CalSol/calsol-hw-libs/README.md

# calsol-hw-libs
CalSol's shared libraries for hardware -- KiCAD libraries and footprints.

## Repository Structure
This is meant to be [submoduled](https://git-scm.com/book/en/v2/Git-Tools-Submodules) into a higher-level project.

- [layout.pretty] - Footprints go here.
- [schematic] - Schematic elements go here.
- [schematic_kicad] - This is a dump of the current KiCAD library set. Don't change these unless you have a compelling reason to (ie. the KiCAD libraries have been updated)
