CalSol/calsol-hw-libs/3D_footprints/HX1188NLT/HX1188NLT.stp

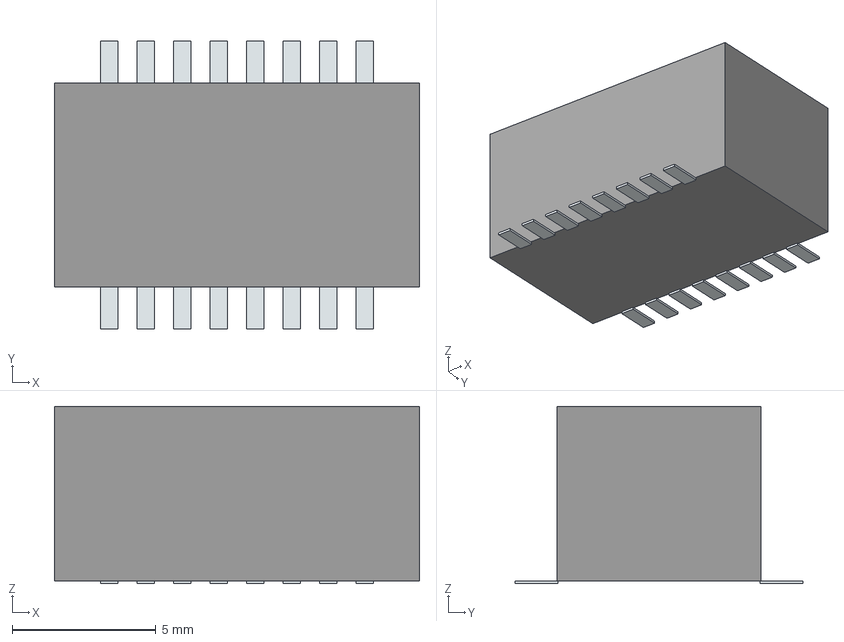
[picture p1: CAD file, 2019-12-28]
3D_footprints/HX1188NLT/HX1188NLT.stp
12.7 x 10.0 x 6.17 mm
('pin',_'1')
('pin',_'2')
('pin',_'3')
('pin',_'4')
('pin',_'5')
('pin',_'6')
('pin',_'7')
('pin',_'8')
('pin',_'9')
('pin',_'10')
('pin',_'11')
('pin',_'12')
('pin',_'13')
('pin',_'14')
('pin',_'15')
('pin',_'16')
