CalSol/calsol-hw-libs/3D_footprints/LTC2309HF#PBF/LTC2309HF#PBF.stp

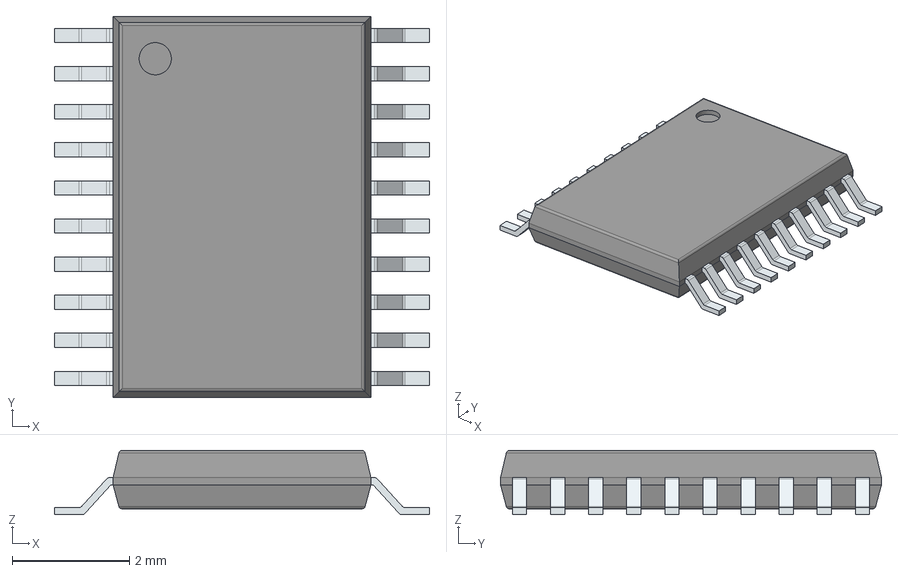
[picture p2: CAD file, 2019-12-28]
3D_footprints/LTC2309HF#PBF/LTC2309HF#PBF.stp
6.40 x 6.50 x 1.10 mm
PinsArrayLR
