CalSol/calsol-hw-libs/3D_footprints/LTC6811-1/LTC6811-1.stp

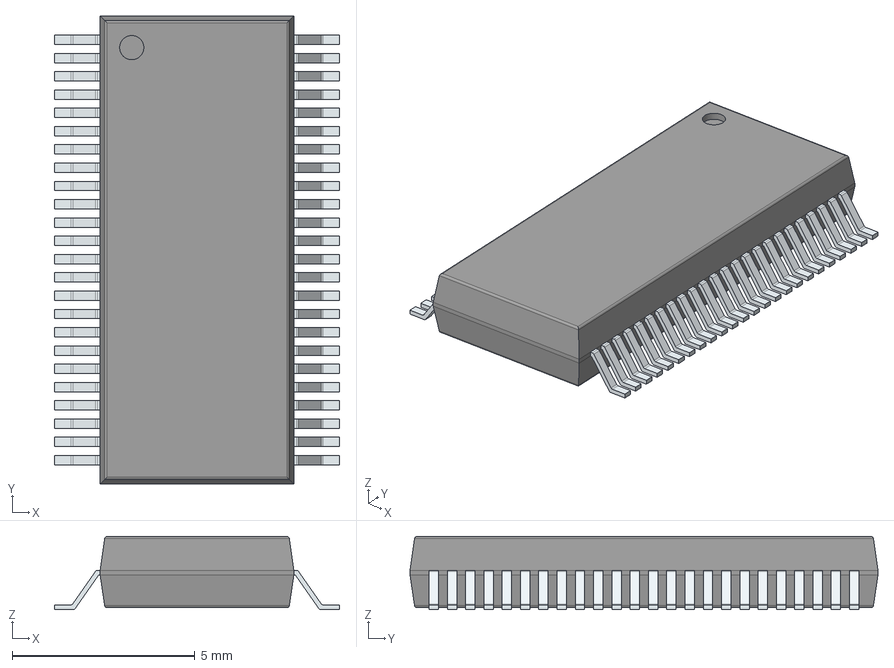
[picture p3: CAD file, 2019-12-28]
3D_footprints/LTC6811-1/LTC6811-1.stp
7.80 x 12.8 x 2.00 mm
PinsArrayLR
