CalSol/calsol-hw-libs/3D_footprints/MOLEX_5023520400/5023520400.stp

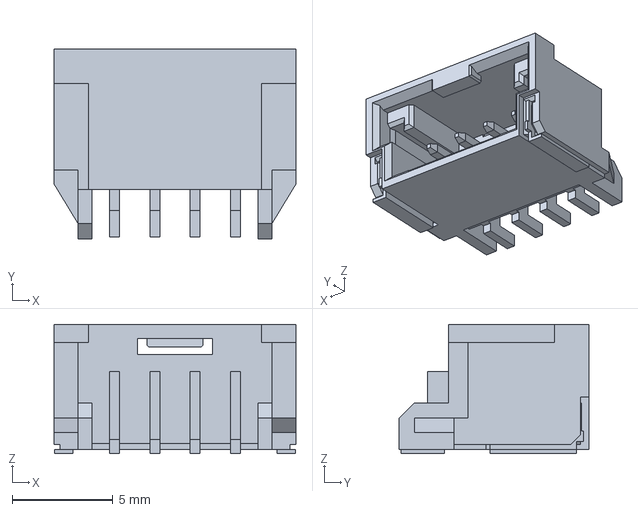
[picture p4: CAD file, 2019-12-28]
3D_footprints/MOLEX_5023520400/5023520400.stp
12.0 x 9.40 x 6.40 mm
