CalSol/calsol-hw-libs/3D_footprints/MOLEX_5023520500/5023520500.stp

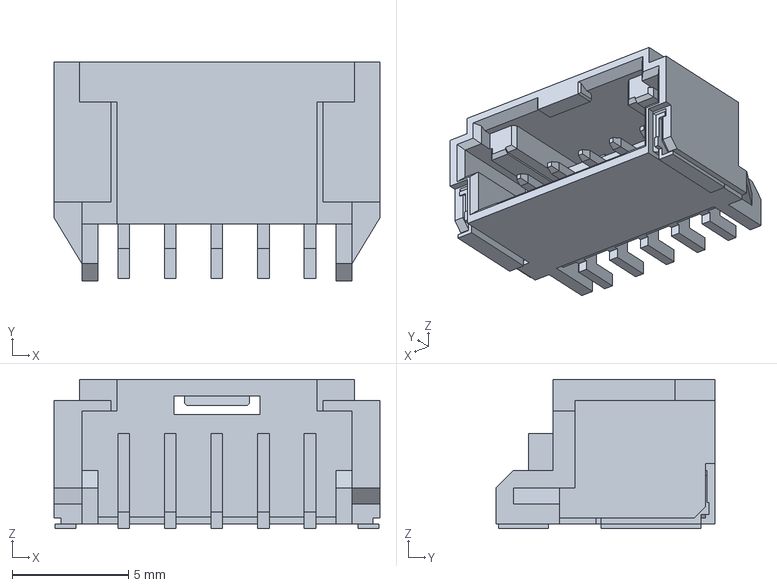
[picture p5: CAD file, 2019-12-28]
3D_footprints/MOLEX_5023520500/5023520500.stp
14.0 x 9.40 x 6.40 mm
