CalSol/calsol-hw-libs/3D_footprints/MOLEX_5600200220/5600200220.stp

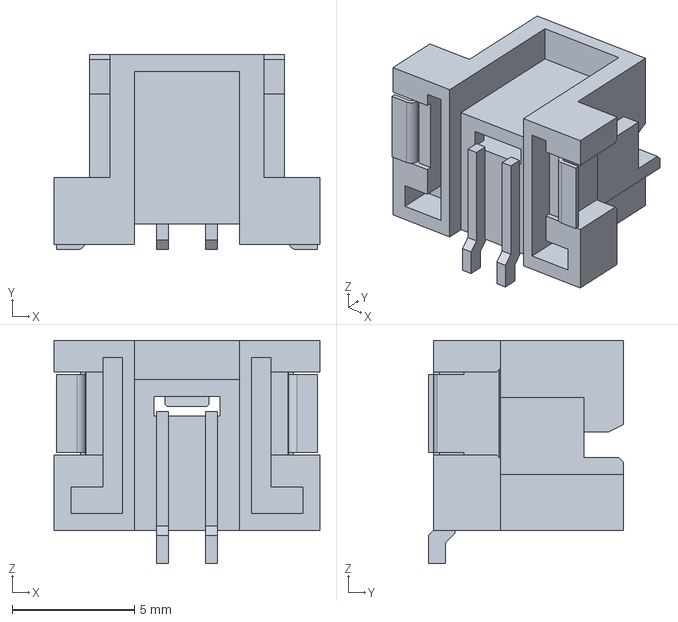
[picture p6: CAD file, 2019-12-28]
3D_footprints/MOLEX_5600200220/5600200220.stp
10.9 x 8.00 x 9.15 mm
