CalSol/calsol-hw-libs/3D_footprints/MOLEX_5600200320/5600200320.stp

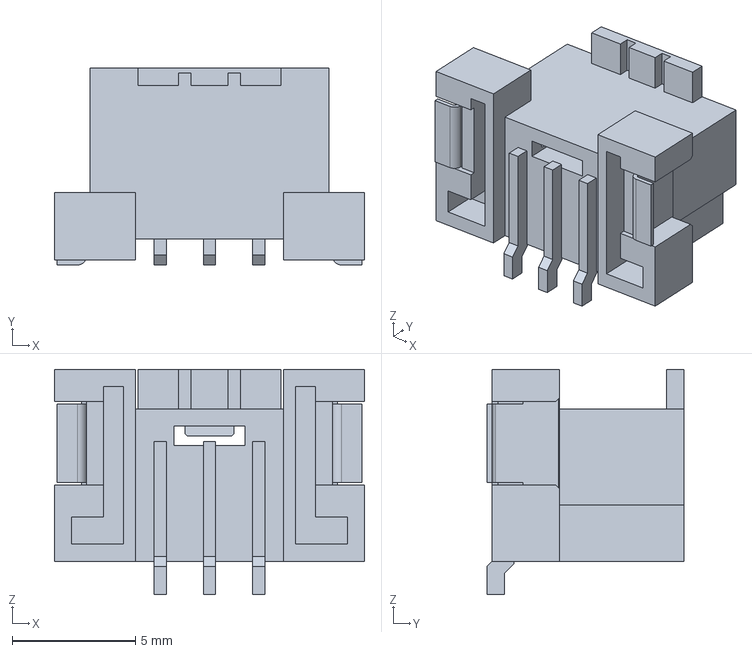
[picture p7: CAD file, 2019-12-28]
3D_footprints/MOLEX_5600200320/5600200320.stp
12.6 x 8.00 x 9.15 mm
