CalSol/calsol-hw-libs/3D_footprints/MOLEX_5600200420/5600200420.stp

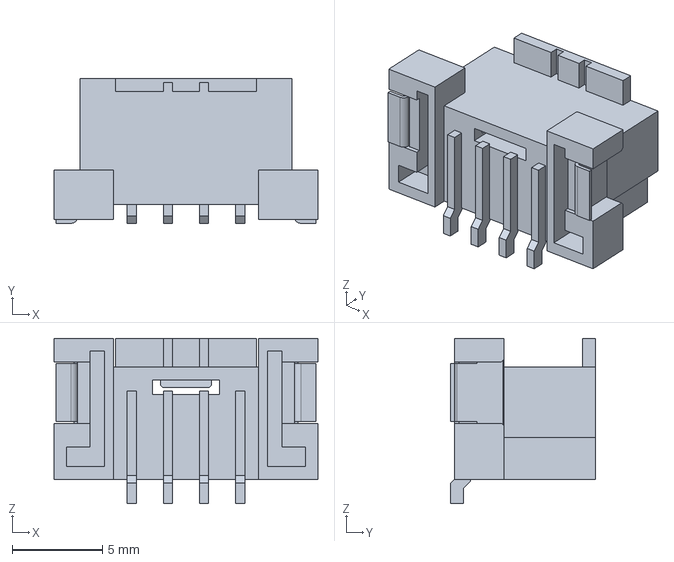
[picture p8: CAD file, 2019-12-28]
3D_footprints/MOLEX_5600200420/5600200420.stp
14.6 x 8.00 x 9.15 mm
