CalSol/calsol-hw-libs/3D_footprints/MOLEX_5600200520/5600200520.stp

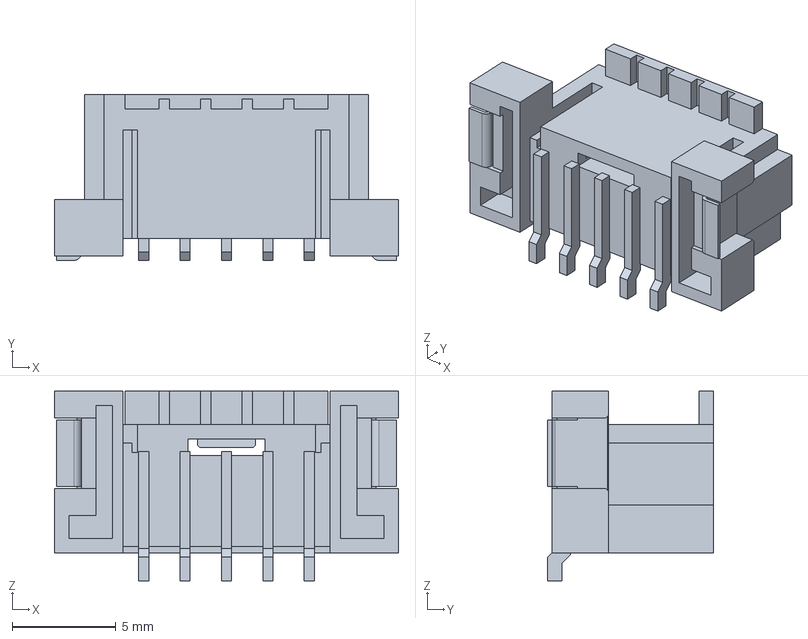
[picture p9: CAD file, 2019-12-28]
3D_footprints/MOLEX_5600200520/5600200520.stp
16.6 x 8.00 x 9.15 mm
