CalSol/calsol-hw-libs/3D_footprints/MOLEX_5600200620/5600200620.stp

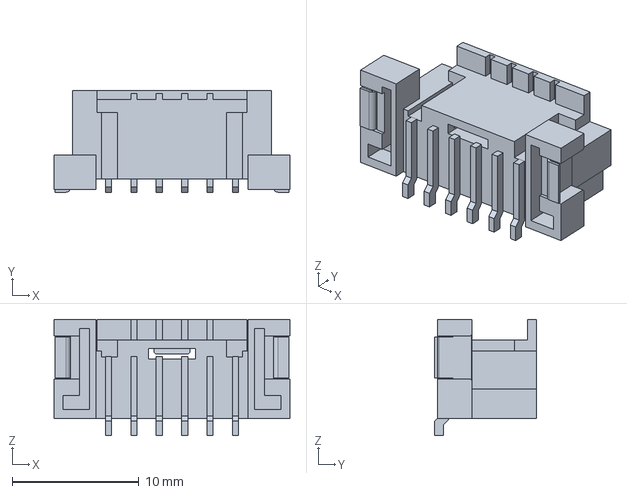
[picture p10: CAD file, 2019-12-28]
3D_footprints/MOLEX_5600200620/5600200620.stp
18.6 x 8.00 x 9.15 mm
