CalSol/calsol-hw-libs/3D_footprints/MOLEX_5600200820/5600200820.stp

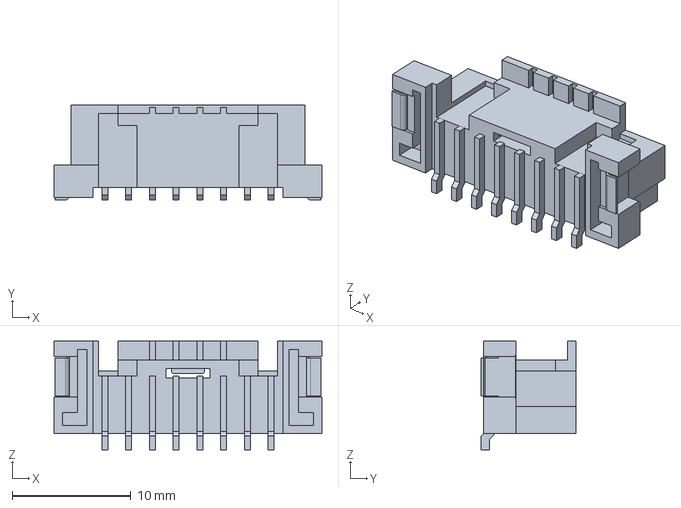
[picture p11: CAD file, 2019-12-28]
3D_footprints/MOLEX_5600200820/5600200820.stp
22.6 x 8.00 x 9.15 mm
