CalSol/calsol-hw-libs/ESP32 Template/ESP32 DEV/ESP32 DEV.kicad_pcb

## KiCad design ESP32 Template/ESP32 DEV/ESP32 DEV.kicad_pcb (2025-02-03)

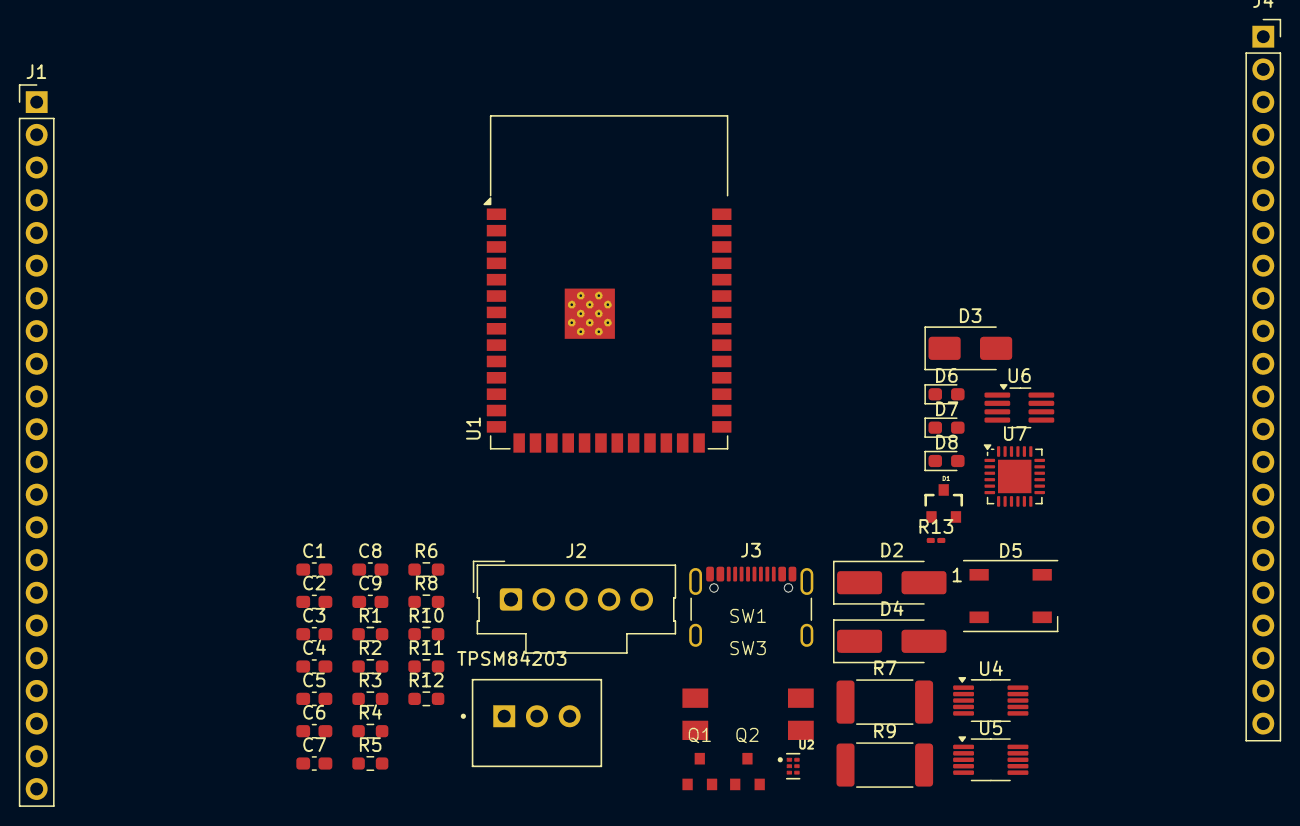
[picture p12: board ESP32 DEV.kicad_pcb from above]

Board: 2 copper layers, 45 parts (0 on the bottom side), 61 nets, no tracks yet.

Parts:
C1, C8: 100uF; C_0603_1608Metric_Pad1.08x0.95mm_HandSolder
C2, C4, C5, C7: 0.1uF; C_0603_1608Metric_Pad1.08x0.95mm_HandSolder
C3, C6: 10uF; C_0603_1608Metric_Pad1.08x0.95mm_HandSolder
C9: 1uF; C_0603_1608Metric_Pad1.08x0.95mm_HandSolder
D1: PESD1CAN; SOT23-3
D2, D4: D; D_SMA_Handsoldering
D3: SMAJ26CA; D_SMA
D5: WS2812B; LED_WS2812B_PLCC4_5.0x5.0mm_P3.2mm
D6, D7, D8: LED; LED_0603_1608Metric_Pad1.05x0.95mm_HandSolder
J1: Conn_01x22_Pin; PinHeader_1x22_P2.54mm_Vertical
J2: Conn_01x05_Socket; Molex_SL_171971-0005_1x05_P2.54mm_Vertical
J3: USB_C_Receptacle_USB2.0_14P; USB_C_Receptacle_GCT_USB4105-xx-A_16P_TopMnt_Horizontal
J4: Conn_01x22_Pin; PinSocket_1x22_P2.54mm_Vertical
Q1, Q2: NPN; SS8050
R1, R2: 5.1k; R_0603_1608Metric_Pad0.98x0.95mm_HandSolder
R3: 10; R_0603_1608Metric_Pad0.98x0.95mm_HandSolder
R4, R5, R10, R11: 10k; R_0603_1608Metric_Pad0.98x0.95mm_HandSolder
R6: 1k; R_0603_1608Metric_Pad0.98x0.95mm_HandSolder
R7, R9: 0.02; R_2512_6332Metric_Pad1.40x3.35mm_HandSolder
R8: 1K; R_0603_1608Metric_Pad0.98x0.95mm_HandSolder
R12: 220; R_0603_1608Metric_Pad0.98x0.95mm_HandSolder
R13: 220; R_0201_0603Metric_Pad0.64x0.40mm_HandSolder
SW1, SW3: SW_Push; PTS636_SM43_SMTR_LFS
TPSM84203: CONV_TPSM84205EAB
U1: ESP32-S3-WROOM-1
U2: TPD4S012DRYR; PSON50P145X100X60-6N
U4, U5: LTC4151xMS; MSOP-10_3x3mm_P0.5mm
U6: TCAN332; TSOT-23-8_HandSoldering
U7: CP2102N-Axx-xQFN24; QFN-24-1EP_4x4mm_P0.5mm_EP2.6x2.6mm

Connections:
+3.3V: C1.1, C4.1, C6.1, C7.1, C8.1, C9.1, D5.1 (VDD), J1.1, J4.22, R8.1, R10.1, R11.1, R12.2, R13.2, TPSM84203.2 (VOUT), U1.2 (3V3), U6.3 (VCC), U7.5 (VIO), U7.6 (VDD)
+5V: D4.2 (A), J3.A4 (VBUS), J3.A9 (VBUS), J3.B4 (VBUS), J3.B9 (VBUS), J4.21, R3.1, U2.6 (VBUS), U7.7 (VREGIN), U7.8 (VBUS)
+24V: D2.2 (A), D3.1 (A1), J1.20, J2.2, R7.1, U4.1 (SENSE+), U4.2 (VIN), U4.3 (ADR1), U5.2 (VIN)
/24V_out: J1.21, R7.2, U4.10 (SENSE-)
/BC V_in: C3.1, D2.1 (K), D4.1 (K), R9.1, U5.1 (SENSE+), U5.3 (ADR1), U5.4 (ADR0)
/BC V_out: R9.2, TPSM84203.1 (VIN), U5.10 (SENSE-)
/CANH: D1.1, J2.4, U6.7 (CANH)
/CANL: D1.2, J2.5, U6.6 (CANL)
/CC1: J3.A5 (CC1), R1.1
/CC2: J3.B5 (CC2), R2.1
/DTR: Q2.3 (E), R4.1, U7.23 (~DTR)
/D_N: J3.A7 (D-), J3.B7 (D-), U2.2 (D-), U7.4 (D-)
/D_P: J3.A6 (D+), J3.B6 (D+), U2.1 (D+), U7.3 (D+)
/EN: C5.1, J1.2, Q1.1 (C), SW1.2, U1.3 (EN)
/IO0: C2.1, J4.14, Q2.1 (C), SW3.2, U1.27 (IO0)
/IO1: J4.2, U1.39 (IO1)
/IO2: J4.3, U1.38 (IO2)
/IO3: J1.14, U1.15 (IO3)
/IO4: J1.3, U1.4 (IO4)
/IO5: J1.4, U1.5 (IO5)
/IO6: J1.5, U1.6 (IO6)
/IO7: J1.6, U1.7 (IO7)
/IO8: J1.11, U1.12 (IO8)
/IO9: J1.16, U1.17 (IO9)
/IO10: J1.17, U1.18 (IO10)
/IO11: J1.18, U1.19 (IO11)
/IO12: J1.19, U1.20 (IO12)
/IO13: J4.20, U1.21 (IO13)
/IO14: J4.19, U1.22 (IO14)
/IO15: J1.7, U1.8 (IO15)
/IO16/U2RXD: J1.8, U1.9 (IO16), U7.21 (TXD)
/IO17/U2TXD: J1.9, U1.10 (IO17), U7.20 (RXD)
/IO18: J1.10, U1.11 (IO18)
/IO19: J1.12, R6.1, U1.13 (IO19)
/IO20/SDA: J1.13, R10.2, U1.14 (IO20), U4.7 (SDA), U5.7 (SDA)
/IO21/SCL: J4.18, R11.2, U1.23 (IO21), U4.6 (SCL), U5.6 (SCL)
/IO35: J4.13, U1.28 (IO35)
/IO36: J4.12, U1.29 (IO36)
/IO37: J4.11, U1.30 (IO37)
/IO38: J4.10, U1.31 (IO38)
/IO39: J4.9, U1.32 (IO39)
/IO40: J4.8, U1.33 (IO40)
/IO41: J4.7, U1.34 (IO41)
/IO42: J4.6, U1.35 (IO42)
/IO45: J4.15, U1.26 (IO45)
/IO46: J1.15, U1.16 (IO46)
/IO47: J4.17, U1.24 (IO47)
/IO48: J4.16, U1.25 (IO48)
/RTS: Q1.3 (E), R5.1, U7.19 (~RTS)
/RXD: J4.5, U1.36 (RXD0), U6.4 (RXD)
/TXD: J4.4, U1.37 (TXD0), U6.1 (TXD)
GND: C1.2, C2.2, C3.2, C4.2, C5.2, C6.2, C7.2, C8.2, C9.2, D1.3, D3.2 (A2), D5.3 (VSS), D8.1 (K), J1.22, J2.3, J3.A1 (GND), J3.A12 (GND), J3.B1 (GND), J3.B12 (GND), J3.S1 (SHIELD), J4.1, R1.2, R2.2, SW1.1, SW3.1, TPSM84203.3 (GND), U1.1 (GND), U1.40 (GND), U1.41 (GND), U2.4 (GND), U4.4 (ADR0), U4.5 (ADIN), U4.9 (GND), U5.5 (ADIN), U5.9 (GND), U6.2 (GND), U7.2 (GND), U7.25 (GND)
unnamed: D5.4 (DIN), R6.2
unnamed: D6.2 (A), R12.1
unnamed: D6.1 (K), U7.14 (~TXT/GPIO.0)
unnamed: D7.2 (A), R13.1
unnamed: D7.1 (K), U7.13 (~RXT/GPIO.1)
unnamed: D8.2 (A), R8.2
unnamed: Q1.2 (B), R4.2
unnamed: Q2.2 (B), R5.2
unnamed: R3.2, U7.9 (~RST)
