CalSol/calsol-hw-libs/(commit log)

2018-02-26 Created footprint for Bud PN-1335 enclosure outline
2018-02-26 made m4 screw terminal pads wider because previous values were unmanufacturable according to instantdfm
2018-03-06 Reverted LED
2018-03-06 Added some BMS chips
2018-03-09 Screw Terminal Update
2018-03-12 Adding Powerpole
2018-03-12 final try adding Maxim ADC
2018-04-06 Aux BMS parts
2018-04-07 Updated power pins
2018-04-19 Added CTX33-3 and DCU-8 footprint
2018-05-10 Add transformers and 48 pin microcontrollers
2018-05-27 Make Littelfuse 154 pattern a little easier to solder
2018-06-06 Add in crystal with nicer footprint
2018-06-13 Set pin I/O characteristics correctly
2018-08-25 Add combo discrete SMD and inline header footprints
2019-04-28 Update default footprint libs
2019-05-06 Add in footprints for various connectors and inductor
2019-05-29 Supercap footprint (maybe someone can find a better name)
2019-07-16 Add iso regulators
2019-07-20 Footprint origin of BRAINv3.3 is now in the centre
2019-09-05 Add mounting bosses outline
2019-12-09 Add MP pin name to DuraClick mounting pins
2019-12-23 increase pad size of LT chip footprints
2019-12-23 update rgb led footprint to be bigger
2019-12-28 add 3d models to some footprints
    [5023520400.stp, 5023520500.stp, 5600200220.stp, 5600200320.stp, 5600200420.stp, 5600200520.stp, 5600200620.stp, 5600200820.stp]
2020-01-02 attempt to fix enclosure again
2020-02-06 Fix non-continous board outline on PN-1323
2020-02-12 Add footprint for Calsol logo
2020-02-14 Add Littelfuse OMNI-BLOK 154 fuse holder footprint
2020-02-14 Add Murata DEM8045C series inductor footprint
2020-02-14 Add Wurth M2 SMD threaded spacer footprint
2020-02-14 Add TQFP-144 footprint with 7x7mm pad
2020-02-14 Add Cyclone 10 FPGA schematic symbol
2020-04-12 add more enclosure outlines
2021-06-15 Footprint that was uncommitted
2021-08-26 ISE schematic symbol
2021-12-29 Update for 17.5mil x 27.5mil footprint text width and round_rect pads
2021-12-30 add Molex SL right angle THT footprints
2022-02-11 XBee + Supercap + 0603 LED RoundRect + 0606 LED RoundRect
2022-05-31 KiCAD 6 3d models
2022-06-02 CalSol_power => KiCAD6
2022-12-09 CalSol_micro => KiCAD6
    It was bothering me that LPC1549JDB64 was misspelled. It's supposed to be LPC1549JBD64. See? The B and D were swapped. It's all better now.
2023-05-10 Harmonize footprint style and make mfg easier for JLCPCB
2025-02-03 creating template for esp32
    [ESP32 DEV with LTC.kicad_sch, ESP32 DEV.kicad_pcb, ESP32 DEV.kicad_sch, Template.kicad_pcb, Template.kicad_sch]
